MicroMarty/Steady_Node/README.md

# Steady Node

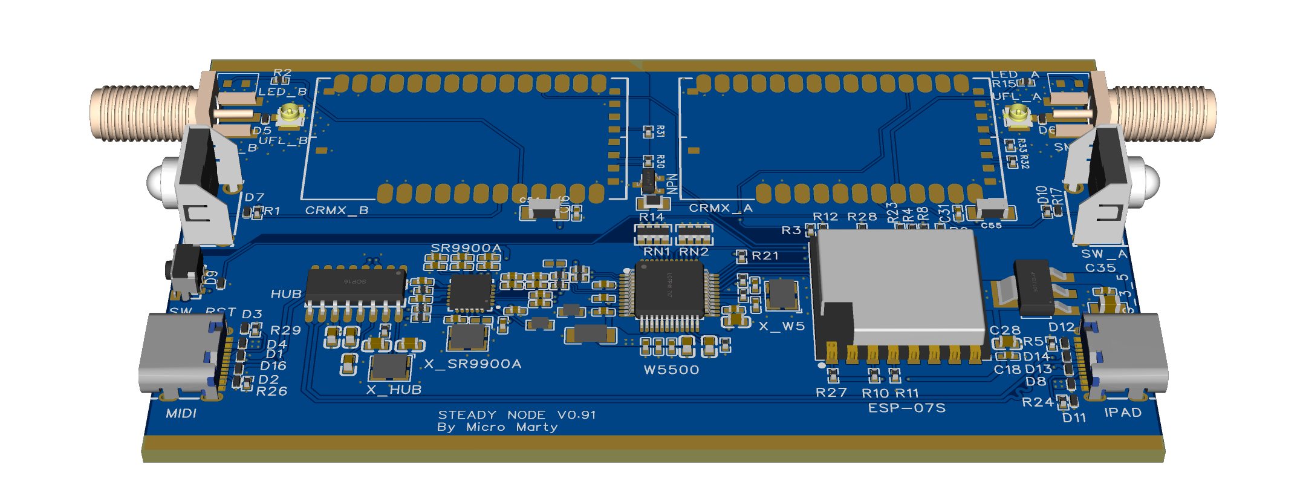
[picture p1: Hardware/3D_PCB_V0.91_2024-10-08.png]
3dpcb

## About:

**Steady Node** is a compact **two univers CRMX transmitter** that can be attached to the back of an **iPad**, with DMX ArtNet data passing through the **USB-C** port.                                                                             
There is also a second USB-C port to connect all kinds of peripherals, like  your favorite MIDI faders, to the iPad.  

It's compatible with all app that support ArtNet, such as Blackout, Luminair and others as it creat a local ethernet network.

Although the project is still under development, it is currently functional, with prototypes already being tested on set.

You can already make it, flash it, and use it!

We hope it will soon be ready for commercial release. 

You can follow its open development here and even participate if you wish :)

## Hardware:

Schematics and PCB are fully accessible on [EasyEDA](https://oshwlab.com/martymicro/v0-91)   

## Credits:
A lot of this project is forked from expanseElectronics and Matt projects.  

You can purchase expanseElectronics nodes by clicking [here](https://expanseelectronics.com/index.html#!/ArtNet-Nodes/c/144555539).
And here is their [GitHub](https://github.com/expanseElectronics/ethernetNodes).  
Matt's ESP8266 based WiFi ArtNet to DMX, RDM and LED Pixels project can be found [here](https://github.com/mtongnz/ESP8266_ArtNetNode_v2).  

I thank Matt and expanseElectronics for their amazing project and all their features!
