MicroMarty/Steady_Node/Hardware/Logic Diagram V0.91.jpg

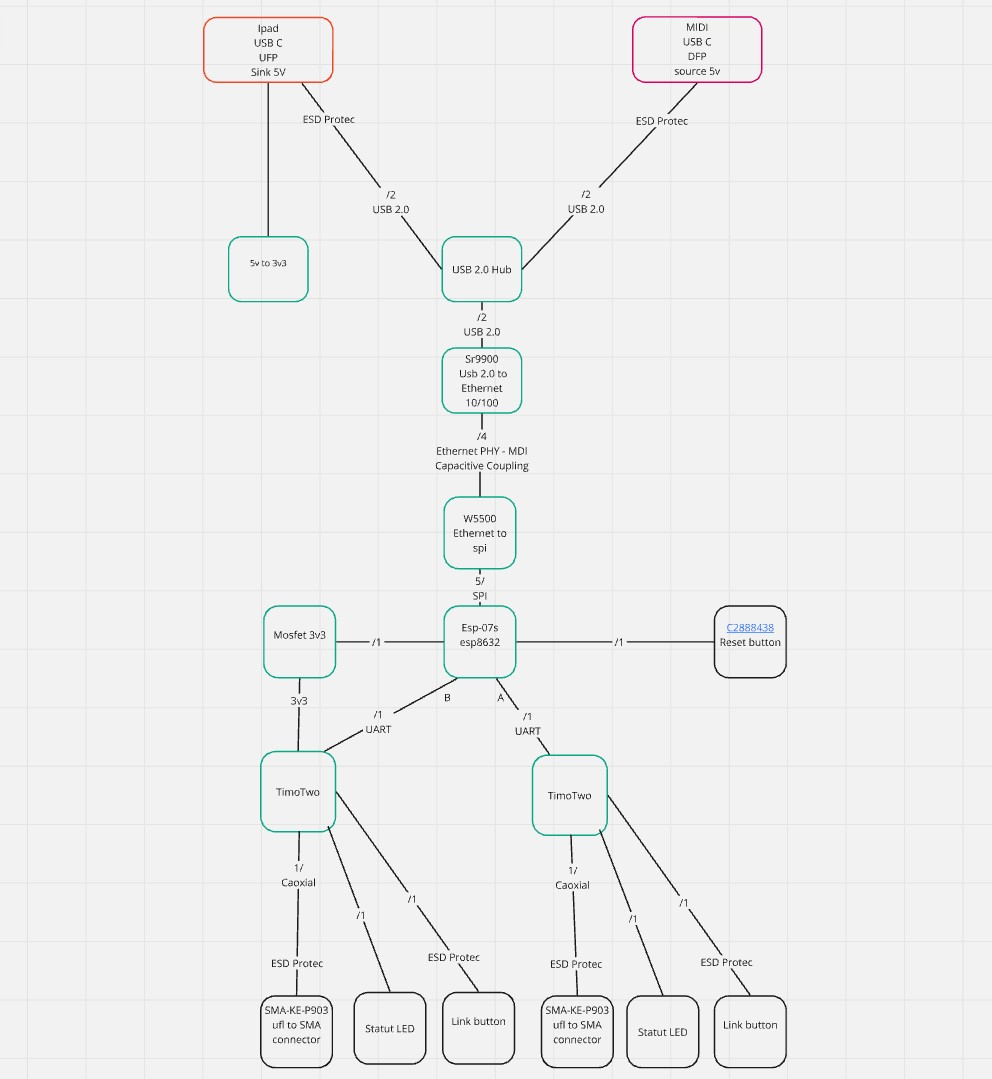
Hardware/Logic Diagram V0.91.jpg
