MicroMarty/Steady_Node/Hardware/Production Files/BOM_V0.91_PCB_V0.91_2024-10-08.xlsx

No. | Quantity | Comment | Designator | Footprint | Value | Manufacturer Part | Manufacturer | Supplier Part | Supplier | LCSC Stock | LCSC Price | JLCPCB Stock | JLCPCB Price | JLCPCB Part Class | LCSC Assembly
1 | 5 | 10uF | C1,C6,C20,C28,C40 | C0603 |  | CL10A106MA8NRNC | SAMSUNG(三星) | C96446 | LCSC |  |  | 2192156 | 0.106 | Basic Part
2 | 4 | 20pF | C3,C10,C42,C48 | C0402 |  | 0402CG200J500NT | FH(风华) | C1554 | LCSC |  |  | 4231702 | 0.0055 | Basic Part
3 | 19 | 100nF | C7,C11,C13,C14,C15,C16,C17,C18,C21,C22,C23,C26,C27,C29,C31,C33,C35,C37,C51 | C0402 |  | CL05B104KB54PNC | SAMSUNG(三星) | C307331 | LCSC |  |  | 3509271 | 0.0306 | Basic Part
4 | 2 | 33pF | C8,C12 | C0603 |  | CL10C330JB8NNNC | SAMSUNG(三星) | C1663 | LCSC |  |  | 699751 | 0.0289 | Basic Part
5 | 1 | 1uF | C19 | C0402 |  | CL05A105KA5NQNC | SAMSUNG(三星) | C52923 | LCSC |  |  | 3034772 | 0.019 | Basic Part
6 | 1 | 4.7uF | C30 | C0603 |  | CL10A475KO8NNNC | SAMSUNG(三星) | C19666 | LCSC |  |  | 1730736 | 0.0587 | Basic Part
7 | 1 | 10nF | C34 | C0603 |  | 0603B103K500NT | FH(风华) | C57112 | LCSC |  |  | 3502866 | 0.0151 | Basic Part
8 | 1 | 22uF | C36 | C0805 |  | CL21A226MAQNNNE | SAMSUNG(三星) | C45783 | LCSC |  |  | 2662190 | 0.143 | Basic Part
9 | 2 | 4.7uF | C38,C41 | C0402 |  | CL05A475MP5NRNC | SAMSUNG(三星) | C23733 | LCSC |  |  | 706710 | 0.0338 | Basic Part
10 | 1 | 47uF | C43 | C1206 |  | CL31A476MPHNNNE | SAMSUNG(三星) | C96123 | LCSC |  |  | 233308 | 0.432 | Basic Part
11 | 2 | 10nF | C54,C55 | C1206 | 10nF | 1206B103K500NT | FH(风华) | C1846 | LCSC |  |  | 89485 | 0.0834 | Basic Part
12 | 4 | 2.2nF | C56,C57,C58,C59 | C0402 | 2.2nF | 0402B222K500NT | FH(风华) | C1531 | LCSC |  |  | 219481 | 0.0059 | Extended Part
13 | 2 | 6.8nF | C60,C61 | C0402 | 6.8nF | 0402B682K500NT | FH(风华) | C1542 | LCSC |  |  | 70884 | 0.0061 | Extended Part
14 | 2 | Timo Two FX | CRMX_A,CRMX_B | TIMO TWO MODULE |  | TIMOTWO | Lumen | Timo Two FX | LUMEN |  |  | 0
15 | 15 | H5VL10B | D1,D2,D3,D4,D5,D6,D7,D8,D9,D10,D11,D12,D13,D14,D16 | SOD-882_L1.0-W0.6-BI |  | H5VL10B | 宏迦橙 | C7420372 | LCSC |  |  | 162320 | 0.0295 | Extended Part
16 | 1 | ESP-07s | ESP-07S | WIRELM-SMD_ESP-07S |  | ESP-07S | Ai-Thinker(安信可) | C82895 | LCSC |  |  | 842 | 16.96 | Extended Part
17 | 1 | AMS1117-3.3 | G_3_5 | SOT-223-3_L6.5-W3.4-P2.30-LS7.0-BR |  | AMS1117-3.3 | AMS | C6186 | LCSC |  |  | 419793 | 0.87 | Basic Part
18 | 1 | SL2.1A | HUB | SOP-16_L10.0-W3.9-P1.27-LS6.0-BL |  | SL2.1A | CoreChips | C192893 | LCSC |  |  | 413 | 1.523 | Extend
19 | 2 | GT-USB-7010AN | IPAD,MIDI | USB-SMD_GT-USB-7010AN |  | GT-USB-7010AN | G-Switch(品赞) | C963370 | LCSC |  |  | 2295 | 1.038 | Extended Part
20 | 2 | 594-2504-013F | LED_A,LED_B | 5942504013F |  |  |  |  |  | 35 | 0.3801
21 | 1 | SS8050_C2150 | NPN | SOT-23-3_L2.9-W1.3-P1.90-LS2.4-BR |  | SS8050 | CJ(江苏长电/长晶) | C2150 | LCSC |  |  | 1377538 | 0.0826 | Basic Part
22 | 4 | 47kΩ | R1,R2,R15,R17 | R0402 |  | 0402WGF4702TCE | UNI-ROYAL(厚声) | C25792 | LCSC |  |  | 1318842 | 0.0032 | Basic Part
23 | 2 | 100Ω | R3,R4 | R0402 |  | 0402WGF1000TCE | UNI-ROYAL(厚声) | C25076 | LCSC |  |  | 3431220 | 0.003 | Basic Part
24 | 2 | 5.1kΩ | R5,R24 | R0402 |  | 0402WGF5101TCE | UNI-ROYAL(厚声) | C25905 | LCSC |  |  | 2430800 | 0.0027 | Basic Part
25 | 1 | 1kΩ | R6 | R0402 |  | 0402WGF1001TCE | UNI-ROYAL(厚声) | C11702 | LCSC |  |  | 7563482 | 0.0033 | Basic Part
26 | 11 | 10kΩ | R7,R8,R9,R10,R11,R12,R16,R18,R20,R21,R23 | R0402 |  | 0402WGF1002TCE | UNI-ROYAL(厚声) | C25744 | LCSC |  |  | 5984277 | 0.0032 | Basic Part
27 | 1 | 100kΩ | R13 | R0402 |  | 0402WGF1003TCE | UNI-ROYAL(厚声) | C25741 | LCSC |  |  | 2984699 | 0.0032 | Basic Part
28 | 1 | 150Ω | R14 | R0805 |  | 0805W8F1500T5E | UNI-ROYAL(厚声) | C17471 | LCSC |  |  | 642365 | 0.0111 | Basic Part
29 | 1 | 2.4kΩ | R22 | R0603 |  | 0603WAF2401T5E | UNI-ROYAL(厚声) | C22940 | LCSC |  |  | 220126 | 0.0061 | Basic Part
30 | 1 | 1MΩ | R25 | R0402 |  | 0402WGF1004TCE | UNI-ROYAL(厚声) | C26083 | LCSC |  |  | 1666500 | 0.0034 | Basic Part
31 | 2 | 22kΩ | R26,R29 | R0402 |  | 0402WGF2202TCE | UNI-ROYAL(厚声) | C25768 | LCSC |  |  | 732041 | 0.003 | Basic Part
32 | 2 | 3.3kΩ | R27,R28 | R0402 |  | 0402WGF3301TCE | UNI-ROYAL(厚声) | C25890 | LCSC |  |  | 747489 | 0.0032 | Basic Part
33 | 4 | 0Ω | R30,R31,R32,R33 | R0402 | 0Ω | 0402WGF0000TCE | UNI-ROYAL(厚声) | C17168 | LCSC |  |  | 2557110 | 0.0031 | Basic Part
34 | 4 | 49.9Ω | R38,R39,R40,R41 | R0402 | 49.9Ω | 0402WGF499JTCE | UNI-ROYAL(厚声) | C25120 | LCSC |  |  | 721511 | 0.0033 | Basic Part
35 | 1 | 12.4kΩ | R42 | R0603 | 12.4kΩ | 0603WAF1242T5E | UNI-ROYAL(厚声) | C22865 | LCSC |  |  | 70930 | 0.0062 | Extended Part
36 | 2 | 10kΩ | RN1,RN2 | RES-ARRAY-SMD_0603-8P-L3.2-W1.6-BL |  | 4D03WGJ0103T5E | UNI-ROYAL(厚声) | C29718 | LCSC |  |  | 771251 | 0.0356 | Basic Part
37 | 2 | SMA-KE-P903 | SMA_A,SMA_B | SMA-TH_SMA-KE-P903 |  | SMA-KE-P903 | DreamLNK(骏晔科技) | C914558 | LCSC |  |  | 1573 | 5.55 | Extended Part
38 | 1 | SR9900A | SR9900A | QFN-24_L4.0-W4.0-P0.50-BL-EP2.8 |  | SR9900A | CoreChips | C521278 | LCSC |  |  | 0 | 9.34
39 | 2 | KSJ0V41180SHLFTR | SW_A,SW_B | KEY-TH_4P-L9.5-W8.8-P5.08-LS7.6 |  | KSJ0V41180SHLFTR | C&amp;K | C221776 | LCSC |  |  | 2 | 12.97 | Extended Part
40 | 1 | TSA020A3426A | SW_RST | SW-SMD_TSA020XXXXXX |  | TSA020A3426A | BZCN(博众电气) | C2888438 | LCSC |  |  | 1403 | 0.214 | Extended Part
41 | 2 | BWU.FL-IPEX1 | UFL_A,UFL_B | IPEX-SMD_BWIPX-1-001E |  | BWU.FL-IPEX1 | BAT WIRELESS(蝙蝠无线) | C5137195 | LCSC |  |  | 114805 | 0.229 | Extended Part
42 | 1 | W5500 | W5500 | LQFP-48_L7.0-W7.0-P0.50-LS9.0-BL |  | W5500 | WIZNET | C32843 | LCSC |  |  | 24748 | 16.71 | Extended Part
43 | 1 | 12MHz | X_HUB | OSC-SMD_4P-L3.2-W2.5-BL |  | X322512MSB4SI | YXC(扬兴晶振) | C9002 | LCSC |  |  | 264897 | 0.403 | Basic Part
44 | 2 | 25MHz | X_SR9900A,X_W5 | OSC-SMD_4P-L3.2-W2.5-BL |  | X322525MOB4SI | YXC(扬兴晶振) | C9006 | LCSC |  |  | 201450 | 0.378 | Basic Part
