MicroMarty/Steady_Node/(threads)

Thread 1 (2025-01-28):

Removing unused Functions

MicroMarty, 2025-01-28:
-Remove Display function.

Remove the following function from the web interface and from the code:
-Remove Port 3 and Port 4.
-Remove RDM of port 1 and 2.
-Remove Output/Input toggle switch of Port 1.
-Remove Scene from "Failover mode" and "Record Failover" for port 1 and 2.
-Remove Record Selected Failover Scenes button.

Thread 2 (2025-01-28):

Add a toggle switch to turn on CRMX B module

MicroMarty, 2025-01-28:
In the web interface, above Port 2 settings, add a new toggle switch:
The left side is Off, the right is On.
In default Config, it's Off.
On off position pin PA15 must be LOW (GND), On high pin PA15 must be High (3V3).

Closed 2025-07-13.

Thread 3 (2025-01-28):

Set CRMX modules as RX when ports is set to Input

MicroMarty, 2025-01-28:
Add Functionality to ports 1 and 2 settings to set CRMX modules A and B to RX when ports are set to DMX input.

CRMX TimoTwo FX module can be TX or RX, this can be select by Flex mode using digital input.
https://docs.lumenrad.io/timotwo/flex-mode/
In TX mode they transmit CRMX from DMX signal output from the STM32, in RX mode they Receive CRMX and input DMX signal it to the STM.

When port 1 is set to Input in the web interface, Pin PB13 must be pull High. And low when set to Output.
When port 2 is set to Input in the web interface, Pin PB12 must be pull High. And low when set to Output.

MicroMarty, 2025-02-10:
If it's easier, we can assign another pin to do the pull down, pull up. To keep DMX code unchanged.

MicroMarty, 2025-03-22:
Wouldn't it be simpler to invert the voltage of the DE pins of ports 1 and 2 depending on the output/input?

Closed 2025-07-13.

Thread 4 (2025-02-10):

Hardware - Reset switch not working

MicroMarty, 2025-02-10:
On current hardware version, Config reset switch don't work.
I don't know why, maybe I have done some damage inside the SMT32 with ESD...

MicroMarty, 2025-02-13:
Working, the switch must be press for 5s.
And I remove the capacitor closing the switch as it pull high boot0 and make the stm32 booting in DFU mode.

Closed 2025-02-13.

Thread 5 (2025-06-10):

Fix the switch between Input and Output

MicroMarty, 2025-06-10:
At the moment, when the node ports are switched between Input and Output, it's need one or two reboot for the port to operate as expected.
It will be best to have it working without any reboot.

Closed 2025-08-03.

Thread 7 (2025-08-07):

Reduce Config Reset Button Duration

MicroMarty, 2025-08-07:
Shorten the required press duration to trigger config reset from 5 seconds to ~100 milliseconds (short tap, one click).

Thread 11 (2025-08-11):

Optimizing the WebUI

MicroMarty, 2025-08-11:
Make the WebUI clearer and easier to use.
Following the ideas from this list and the attached picture:

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

-Merge all WebUI settings into a single page

-Expand the universe field into 3 distinct ones: Art-Net Universe; Sub Net; Net

-Display a confirmation warning dialog when a modification triggers a device reboot or any interruption of the CRMX stream: when the node is updated or when the node’s DHCP IP changes

-Hide the ArtPoll firmware version in the WebUI

-Non-editable fields should have a distinct style (e.g., greyed-out appearance) to differentiate them from editable ones

-Remove the ArtPoll Long Name (Description)

-Remove the Failover setting from the frontend

-Apply Pantone 130U color to the "Steady Node"

-Change button labels:
"Apply Settings" → "Save Settings"
"Reset Config" → "Reset Default Settings"

-Include a SteadyNode icon as the browser tab favicon

-Test and adjust UI layout to ensure full usability and visibility on iPad Mini devices

-Apply a slightly darker gray background color to the WebUI for improved contrast and aesthetics

-Display small helper text or tooltips near input fields to guide the user through configuration options, e.g., short hints like "default"

Thread 12 (2025-08-11):

Fix Mac-Address handling

CShark, 2025-08-11:
Change the static mac address in ncm_netif.c to be depending on the Hardware UUID. Also properly set the first two bits to 0 (unicast) and 1 (localy administered instead of globaly registered) respectively.

Same for the USB-Device in usb_config.c - the two addresses should not be the same though. This one is for the Host-Side (PC or iPad) and the other one for the ArtNet client.
