MicroMarty/Steady_Node/Hardware/SCH_V0.91_2024-10-08-1.pdf

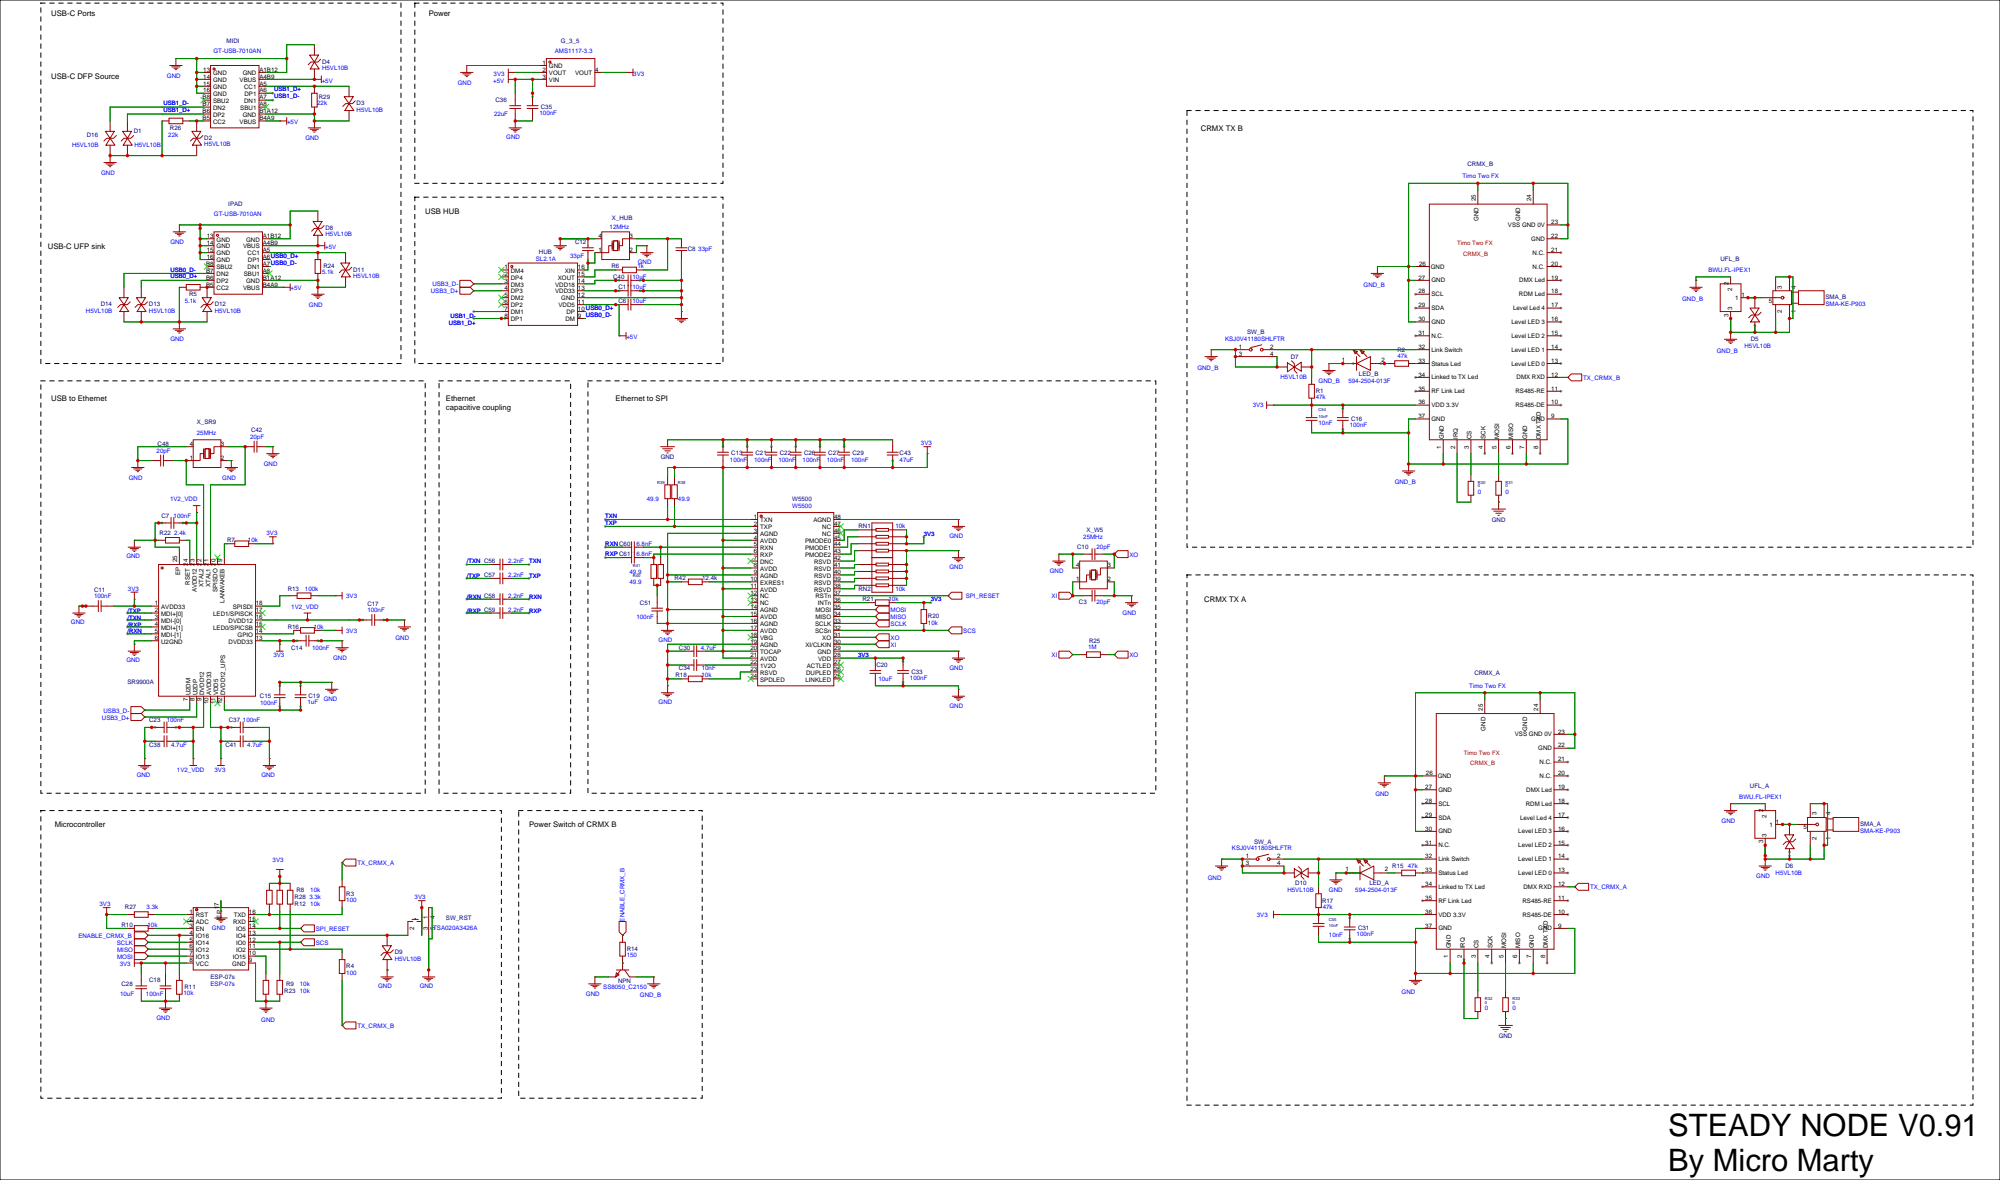
[picture p3: page 1]

DVDD33 13 GPIO 14 LED0/SPICSB 15 DVDD12 16 LED1/SPISCK 17 SPISDI 18 LANWAKEB ¹⁹ SPISDO ²⁰
