MicroMarty/Steady_Node/(commit log)

2024-10-08 Wifi off+ DHCP off + Reset Button
    Initial code mod:
    Ethernet init to pin 0 instead of pin 15 for boot simplicity
    Wifi disable as its not need
    Factory Reset button on pin 4 instead of 5x fast boot
    DHCP off by default for use with device without DHCP server, like IPad
    Pin 16 as command for a MOSFET to power or not CRMX TX B
2024-10-08 Schematic + PCB on EasyEDA pro
2024-10-08 Schematic and PCB
    [BOM_V0.91_PCB_V0.91_2024-10-08.xlsx, PickAndPlace_PCB_V0.91_2024-10-08.xlsx]
2024-10-08 Production Files
    [BOM_V0.91_PCB_V0.91_2024-10-08.xlsx, PickAndPlace_PCB_V0.91_2024-10-08.xlsx]
